cbm-instructions/irgendwas-mit-unicorn/images/irgendwas-mit-unicorns/magnet_mount_options.png

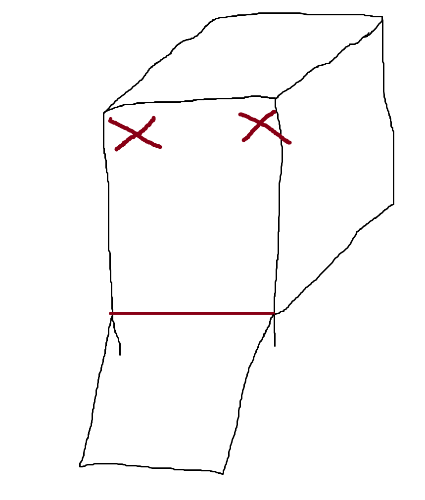
images/irgendwas-mit-unicorns/magnet_mount_options.png
