cbm-instructions/irgendwas-mit-unicorn/images/irgendwas-mit-unicorns/schaltplan.pdf

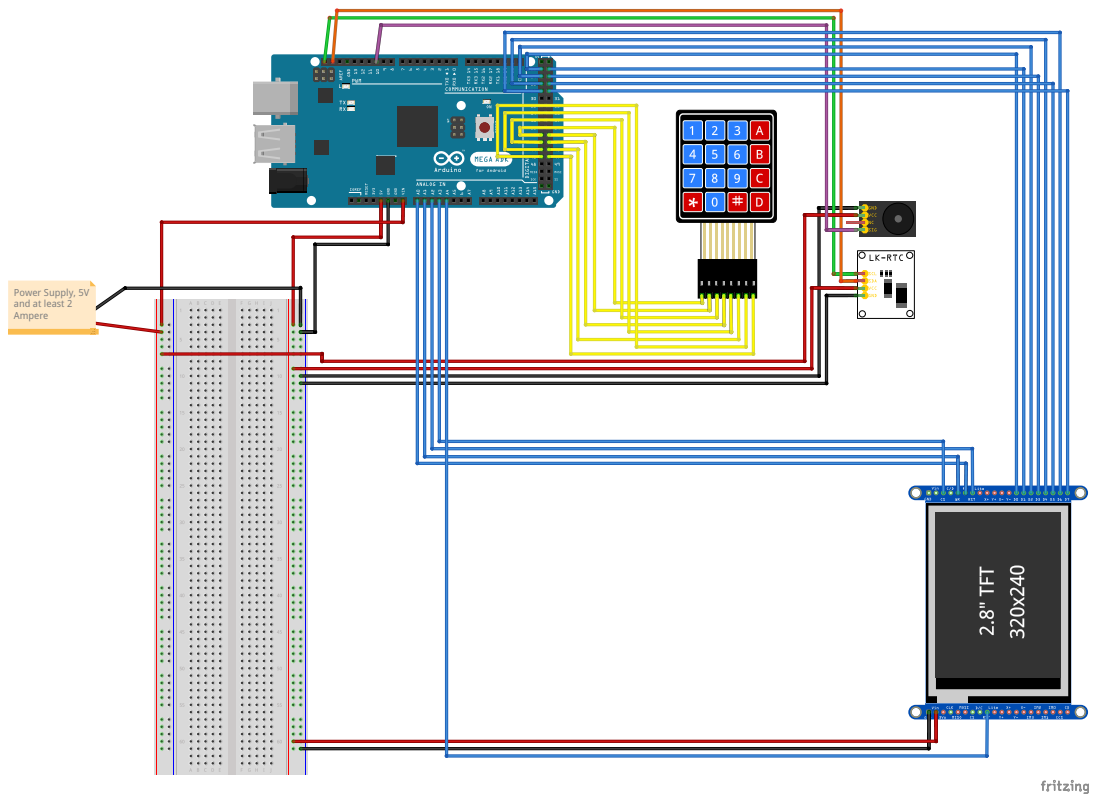
[picture p9: page 1]

Power Supply, 5V
and at least 2
Ampere
