cbm-instructions/irgendwas-mit-unicorn/(commit log)

2022-01-20 change folder structure to make arduino ide happy
2022-01-20 add persistence and move screen printing elements to own file
2022-01-20 fix overflow, sometimes freezing the countdown
    [firmware.ino]
2022-02-02 finish explanation for programming the arduino
2022-02-02 funktionsweise und stromzufuhr
